cuspaceflight/skunk/README.md

skunk
=====

Source code, schematics and documentation for the Skunk Helium Gas Flow Meter Thing
