cuspaceflight/skunk/random docs/skunk pinout.odt

Between DB25 and board molex

board db25 function Colour DB25<=>board

1. 15 keysw orange (live side) brown
2. 13 pot red (to +5V) pink
3. 12 pot yellow (analog output) white
4. 10 piezo black, lcd black, keysw green, pot black (ground) purple
5. 11 piezo red (live side) orange
6. 5 lcd red (3.3V +V) blue
7. 6 lcd violet (Data @3.3V) yellow
8. 19 keypad green C3 brown
9. 18 keypad yellow R1 green
10. 17 keypad violet R4 pink
11. 21 keypad white C2 white
12. 22 keypad pink R2 orange
13. 23 keypad blue R3 blue
14. 25 keypad orange C1 yellow

Keypad colour coding: (between DB25 and keypad itself)

R1 | Yellow
R2 | Pink
R3 | Blue
R4 | Violet
C1 | Orange
C2 | White
C3 | Green

Arduino pin assignments

Pin | Label | Comments | Function | I/O/A | Schematic Label
VIN | Vin | 7-12V recommended | Unregulated power in | I | VIN
GND | GND | | Digital/analog ground | I/O | GND
+5V | +5V | Regulated 5V out | Used for flow-rate pot | O | +5V
PE0 | 0 | UART0 RX | Used for programming | I
PE1 | 1 | UART0 TX | Used for programming | O
PB0 | 53 | UART1 RX | Used for flowmeter comms | I | UART1_RX
PH6 | 9 | UART1 TX | Used for flowmeter comms | O | UART1_TX
PH5 | 3 | | Unused but reserved | -
PH4 | 7 | | Used for LCD comms | O | LCD_DATA
PF0 | A0 | ADC0 | Used for flowrate pot | A | FLOWPOT
PE3 | 5 | Digital pin 5 | Keyswitch input | I | KEYSW_IN
| 37 | Digital pin 37 | Keypad R1 | O | R1
| 35 | Digital pin 36 | Keypad R2 | O | R3
| 36 | Digital pin 35 | Keypad R3 | O | R2
| 34 | Digital pin 34 | Keypad R4 | O | R4
| 33 | Digital pin 33 | Keypad C1 | I | C1
| 32 | Digital pin 32 | Keypad C2 | I | C2
| 31 | Digital pin 31 | Keypad C3 | I | C3
PF1 | A1 | ADC1 | Battery voltage sense | A | BATT_IN
PC7 | 30 | Digital pin 30 | Speaker output | O | SPK

(Pins shown are power input, UART 0 and 1 and 2 used for programming and flowmeter and LCD respectively, and those used for peripherals)

DSUB9 between arduino case and flowmeter

Connection Wire colour DSUB9 pin Board pin

TX Green 1 5

GND Thick black 4 1

RX White 6 4

+V Red 7 3

0V Sense Thin black 8 2
