cuspaceflight/skunk/random docs/skunk random info.pdf

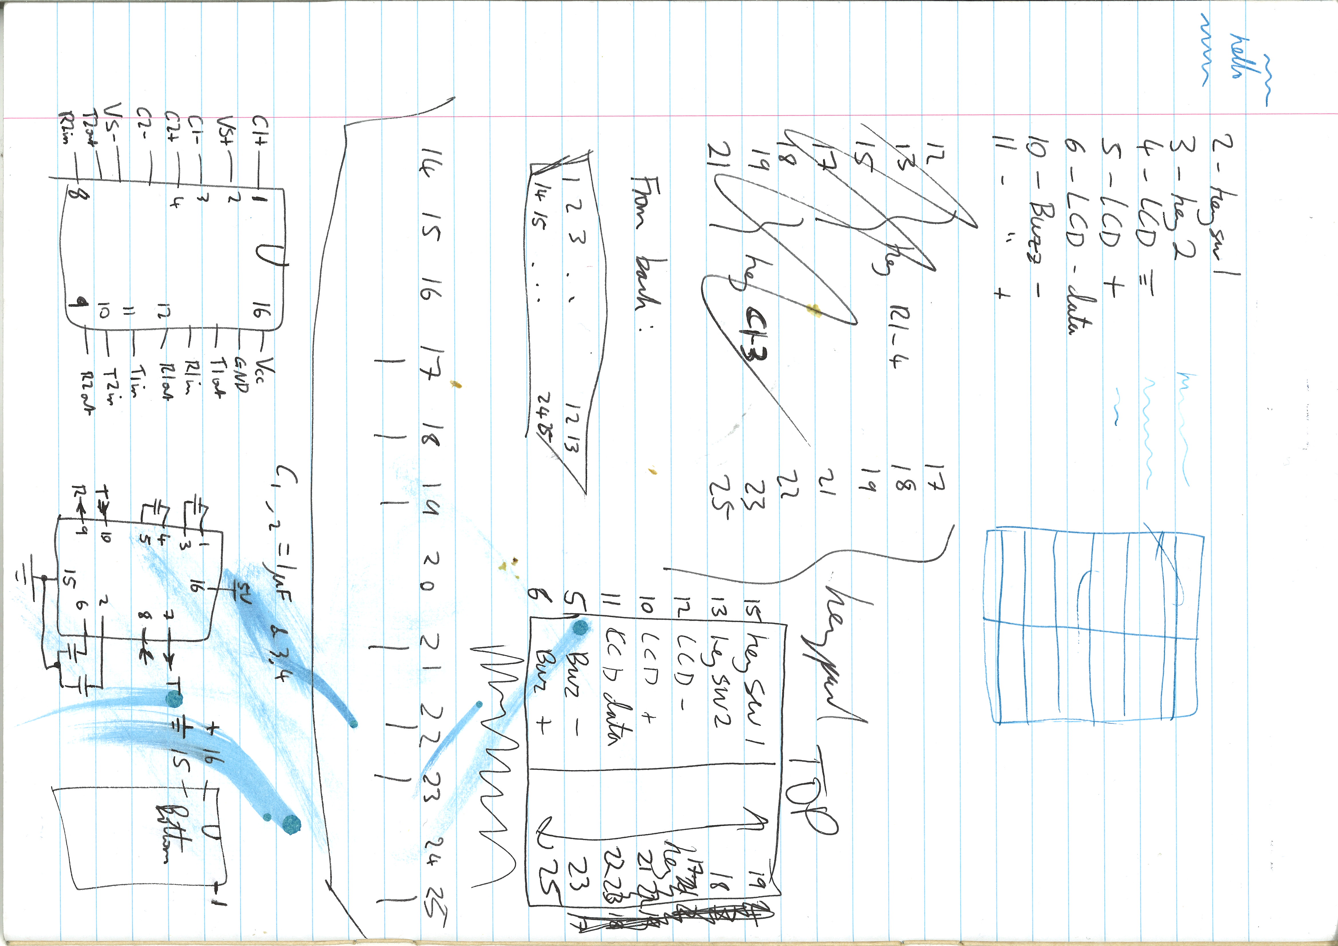
[picture p1: page 1]
