cuspaceflight/skunk/random docs/Skunk prototype parts.ods

Name | Quantity | Source | Part no |  | Link | Comment
Stripboard | 1 |  |  | 7.48 | http://onecall.farnell.com/kelan/147899/stripboard-single-sided/dp/147899
Flow control pot | 1 |  |  | 1.61 | http://onecall.farnell.com/te-connectivity-citec/23esa103mmf50nf/potentiometer-lin-10k/dp/350072 | 6.35mm shaft
Pot knob :) | 1 |  |  | 1.58 | http://onecall.farnell.com/bulgin/kx0607/knob-black/dp/1209726 | 6.35mm shaft
Keypad | 1 |  |  | 4.55 | http://onecall.farnell.com/multicomp/mcak304nbwb/keypad-3x4-array-plastic/dp/1182236 | Numerical + enter/cancel?
Beeper | 1 |  |  | 1.84 | http://onecall.farnell.com/pro-signal/abi-023-rc/piezo-buzzer-12vdc-leads/dp/1022400?Ntt=1022400 | BEEP!
MAX232 | 1 |  |  | 0.7 | http://onecall.farnell.com/texas-instruments/max232in/eia-232-driver-receiver-dual-16dip/dp/1648737
1uF caps for 232 | 5 |  |  | 0.25 | http://onecall.farnell.com/multicomp/np16v105m5x11/capacitor-n-p-1uf-16v/dp/1236655
Pulldowns for keypad | 50 |  |  | 0.4 | http://onecall.farnell.com/multicomp/mcre000049/resistor-carbon-film-125mw-10k/dp/1700251
Keyswitch | 1 |  |  | 2.7 | http://onecall.farnell.com/multicomp/ns106-1/keyswitch-spst-2pos-rdm-1keypull/dp/1735376
