cuspaceflight/skunk/schematics/skunk.sch

## KiCad design schematics/skunk.sch (2013-02-03, an earlier design)

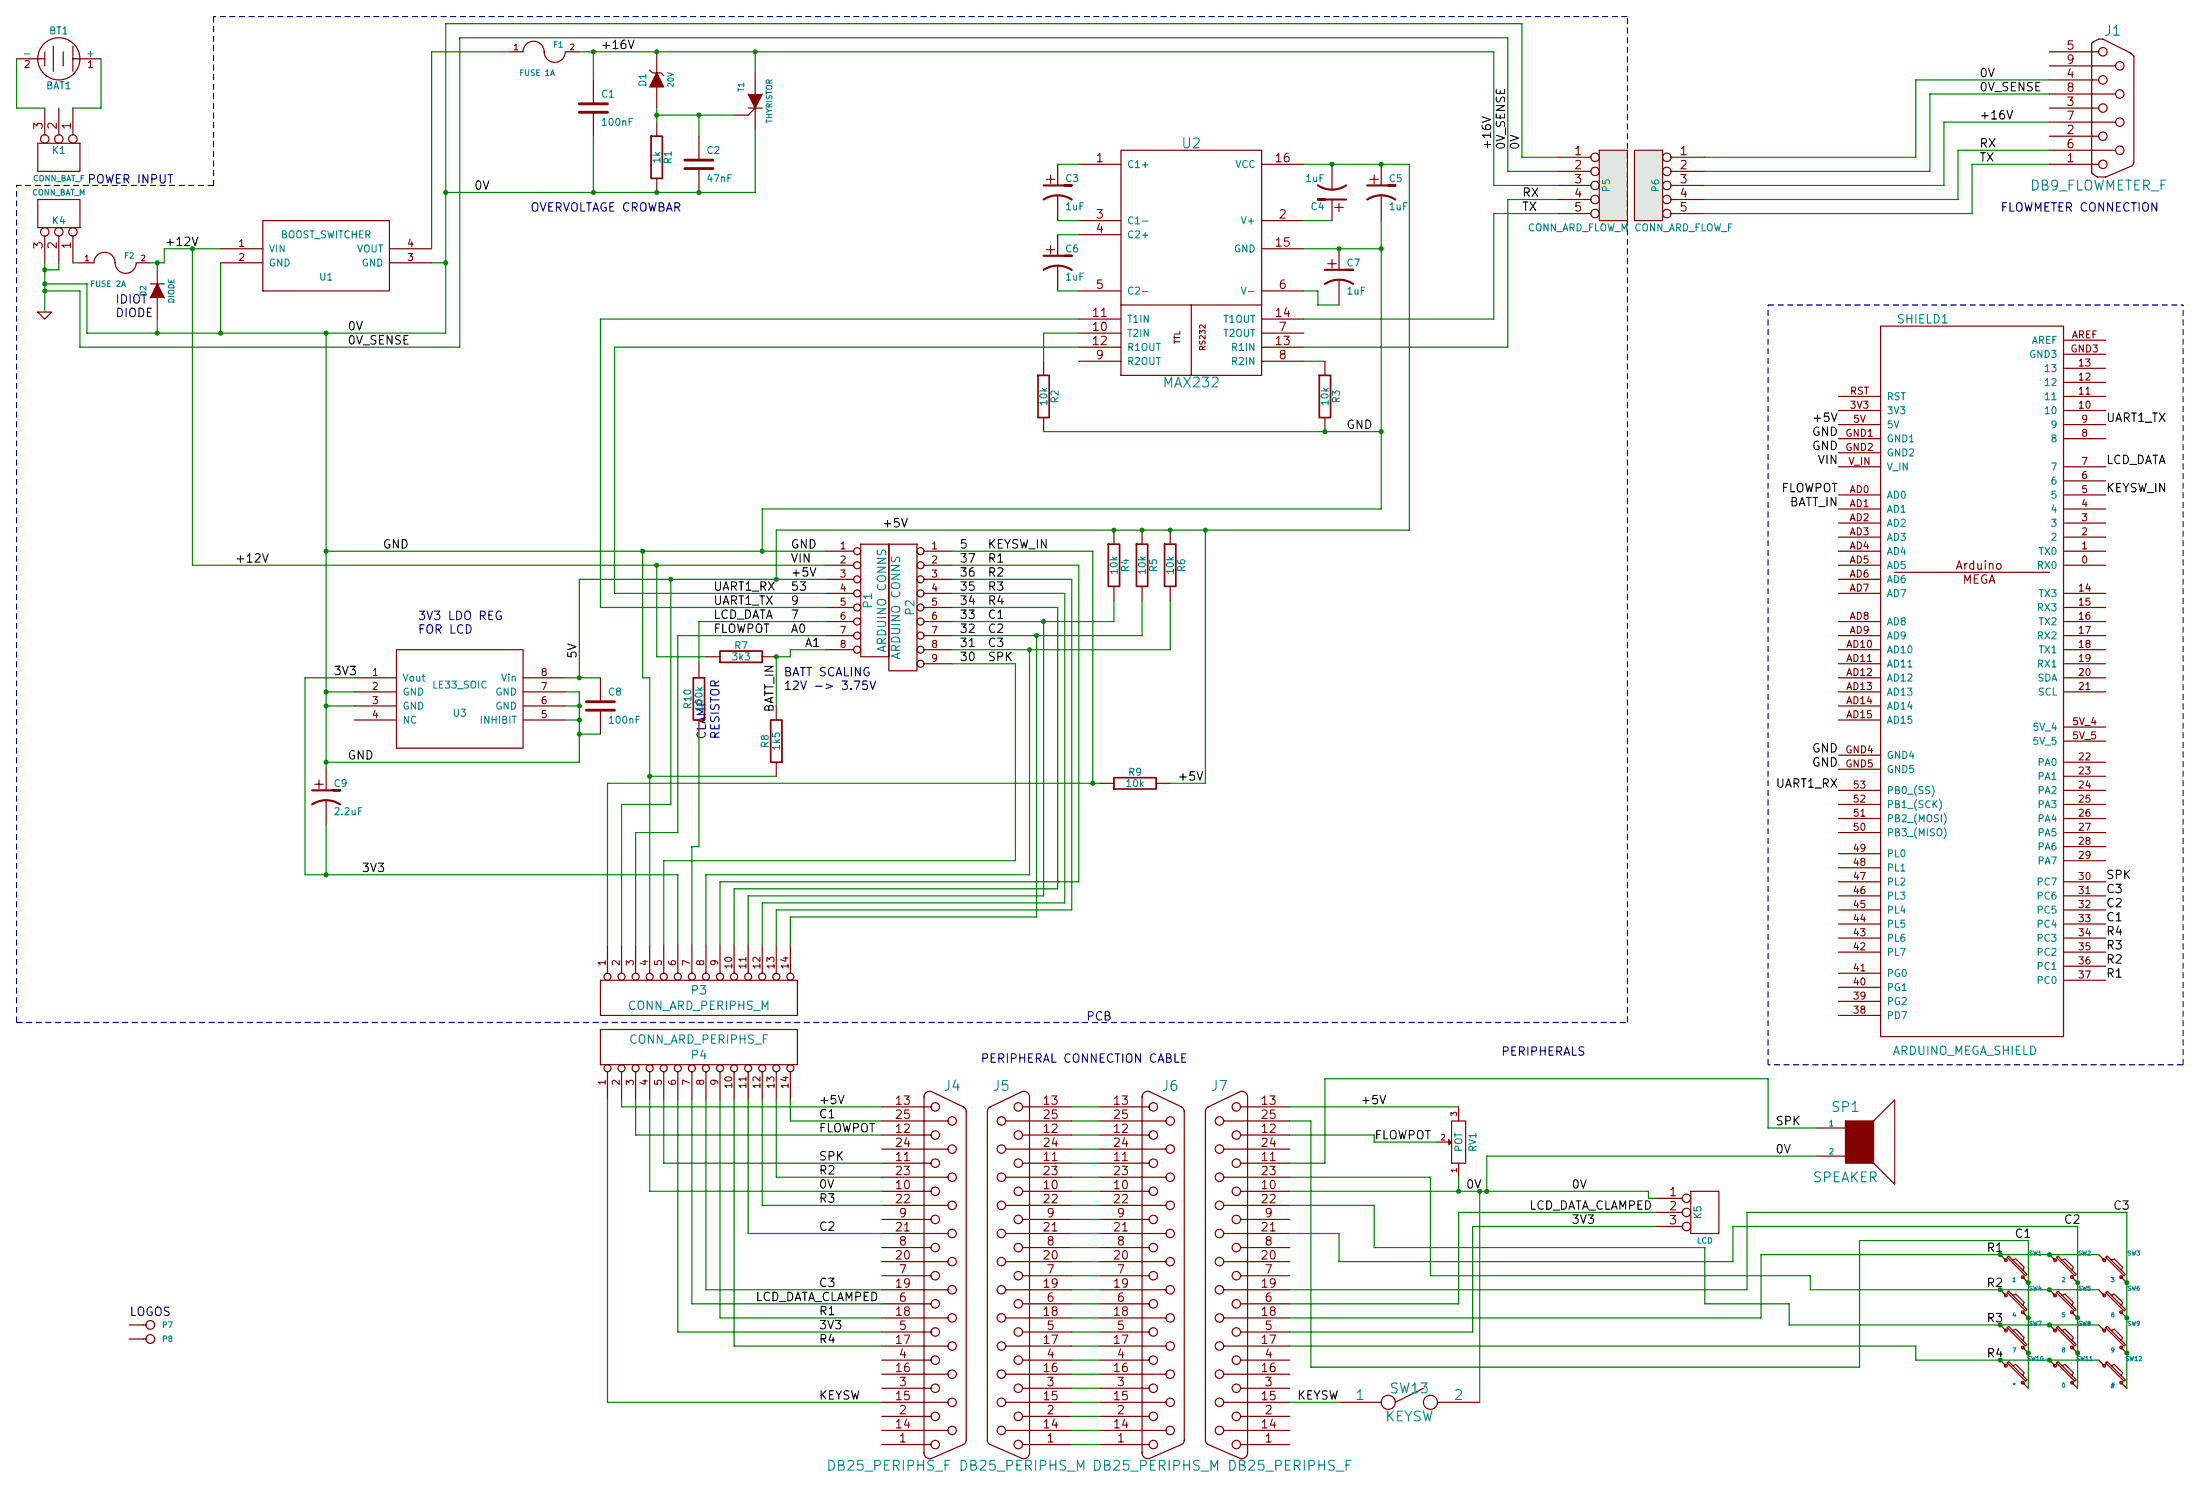
[picture p2: schematic skunk.sch]

Parts:
BT1: BAT1
C1, C8: 100nF; Farnell CA06644
C2: 47nF; Farnell CA06675
C3, C4, C5, C6, C7: 1uF; Farnell 1828853
C9: 2.2uF; Farnell 1828852
D1: 20V; Farnell 1612407
D2: DIODE; Farnell 1624992
F1: FUSE 1A; Farnell 1453528x2,1123079
F2: FUSE 2A; Farnell 1453528x2,1123175
J1: DB9_FLOWMETER_F
J4, J7: DB25_PERIPHS_F
J5, J6: DB25_PERIPHS_M
K1: CONN_BAT_F
K4: CONN_BAT_M; Farnell 1608727
K5: LCD
P1, P2: ARDUINO CONNS
P3: CONN_ARD_PERIPHS_M
P4: CONN_ARD_PERIPHS_F
P5: CONN_ARD_FLOW_M; Farnell 9731679
P6: CONN_ARD_FLOW_F; Farnell 1462874
P7, P8: CONN_1
R1: 1k; Farnell 1500663
R2, R3, R4, R5, R6, R9: 10k; Farnell 1653284
R7: 3k3; Farnell 1500706
R8: 1k5; Farnell 1653291
R10: 100k; Farnell 1653286
RV1: POT
SHIELD1: ARDUINO_MEGA_SHIELD; Farnell 1056428,1098454x2
SP1: SPEAKER
SW1: 1
SW2: 2
SW3: 3
SW4: 4
SW5: 5
SW6: 6
SW7: 7
SW8: 8
SW9: 9
SW10: *
SW11: 0
SW12: #
SW13: KEYSW
T1: THYRISTOR; Farnell 2101366
U1: BOOST_SWITCHER; MODULE
U2: MAX232; Farnell 1470443
U3: LE33_SOIC; MODULE; Farnell 1652371

Connections:
3V3: C9.2, J4.5, J7.5, K5.3, P3.6, P4.6, U3.1 (Vout)
5: P2.1, P3.1, R9.1, SHIELD1.5
7: P1.6, R10.2, SHIELD1.7
9: P1.5, SHIELD1.9, U2.11 (T1IN)
30: J4.11, J7.11, P2.9, P3.5, P4.5, SHIELD1.30 (PC7), SP1.1
31: J4.19, J7.19, P2.8, P3.8, P4.8, R6.2, SHIELD1.31 (PC6), SW3.2, SW6.2, SW9.2, SW12.2
32: J4.21, J7.21, P2.7, P3.14, P4.11, R5.2, SHIELD1.32 (PC5), SW2.2, SW5.2, SW8.2, SW11.2
33: J4.25, J7.25, P2.6, P3.11, P4.14, R4.2, SHIELD1.33 (PC4), SW1.2, SW4.2, SW7.2, SW10.2
34: J4.17, J7.17, P2.5, P3.10, P4.10, SHIELD1.34 (PC3), SW10.1, SW11.1, SW12.1
35: J4.22, J7.22, P2.4, P3.12, P4.12, SHIELD1.35 (PC2), SW7.1, SW8.1, SW9.1
36: J4.23, J7.23, P2.3, P3.13, P4.13, SHIELD1.36 (PC1), SW4.1, SW5.1, SW6.1
37: J4.18, J7.18, P2.2, P3.9, P4.9, SHIELD1.37 (PC0), SW1.1, SW2.1, SW3.1
53: P1.4, SHIELD1.53 (PB0_(SS)), U2.12 (R1OUT)
+5V: C4.2, C5.1, C8.1, J4.13, J7.13, P1.3, P3.2, P4.2, R4.1, R5.1, R6.1, R9.2, RV1.3, SHIELD1.5V, U2.16 (VCC), U3.8 (Vin)
+12V: D2.2 (K), F2.2, P1.2, R7.1, SHIELD1.V_IN, U1.1 (VIN)
+16V: C1.1, D1.2 (K), F1.2, J1.7, P5.3, P6.3, T1.A
A0: J4.12, J7.12, P1.7, P3.3, P4.3, RV1.2, SHIELD1.AD0
A1: P1.8, R7.2, R8.2, SHIELD1.AD1
GND: C1.2, C2.2, C5.2, C7.1, C8.2, C9.1, D2.1 (A), J1.4, J1.8, J4.10, J7.10, K4.2 (PM), K4.3, K5.1, P1.1, P3.4, P4.4, P5.1, P5.2, P6.1, P6.2, R1.2, R2.2, R3.2, R8.1, RV1.1, SHIELD1.GND1, SHIELD1.GND2, SHIELD1.GND4, SHIELD1.GND5, SP1.2, SW13.2, T1.K, U1.2 (GND), U1.3 (GND), U2.15 (GND), U3.2 (GND), U3.3 (GND), U3.5 (INHIBIT), U3.6 (GND), U3.7 (GND)
KEYSW: J4.15, J7.15, P4.1, SW13.1
LCD_DATA_CLAMPED: J4.6, J7.6, K5.2 (PM), P4.7
unnamed: BT1.1 (+), K1.1
unnamed: BT1.2 (-), K1.3
unnamed: C2.1, D1.1 (A), R1.1, T1.G
unnamed: C3.1, U2.1 (C1+)
unnamed: C3.2, U2.3 (C1-)
unnamed: C4.1, U2.2 (V+)
unnamed: C6.1, U2.4 (C2+)
unnamed: C6.2, U2.5 (C2-)
unnamed: C7.2, U2.6 (V-)
unnamed: F1.1, U1.4 (VOUT)
unnamed: F2.1, K4.1
unnamed: J5.1, J6.1
unnamed: J5.2, J6.2
unnamed: J5.3, J6.3
unnamed: J5.4, J6.4
unnamed: J5.5, J6.5
unnamed: J5.6, J6.6
unnamed: J5.7, J6.7
unnamed: J5.8, J6.8
unnamed: J5.9, J6.9
unnamed: J5.10, J6.10
unnamed: J5.11, J6.11
unnamed: J5.12, J6.12
unnamed: J5.13, J6.13
unnamed: J5.14, J6.14
unnamed: J5.15, J6.15
unnamed: J5.16, J6.16
unnamed: J5.17, J6.17
unnamed: J5.18, J6.18
unnamed: J5.19, J6.19
unnamed: J5.20, J6.20
unnamed: J5.21, J6.21
unnamed: J5.22, J6.22
unnamed: J5.23, J6.23
unnamed: J5.24, J6.24
unnamed: J5.25, J6.25
unnamed: P3.7, R10.1
unnamed: R2.1, U2.10 (T2IN)
unnamed: R3.1, U2.8 (R2IN)
RX: J1.6, P5.4, P6.4, U2.13 (R1IN)
TX: J1.1, P5.5, P6.5, U2.14 (T1OUT)

Notes on the sheet:
POWER INPUT
OVERVOLTAGE CROWBAR
IDIOT DIODE
FLOWMETER CONNECTION
PERIPHERAL CONNECTION CABLE
PERIPHERALS
CLAMP RESISTOR
BATT SCALING 12V -> 3.75V
3V3 LDO REG FOR LCD
PCB
LOGOS
