cuspaceflight/skunk/arduino firmware/Skunk-Firmware/SkunkPinDefs.h

#ifndef SKUNKPINDEFS_H
#define SKUNKPINDEFS_H

#define PIN_KEYSW  5

#define PIN_LCD  7

#define PIN_PIEZO  30

#define PIN_KNOB  A0

#define PIN_R1  37
#define PIN_R2  35
#define PIN_R3  36
#define PIN_R4  34
#define PIN_C1  32
#define PIN_C2  33
#define PIN_C3  31

#define FLOW_SERIAL Serial1

#endif
