cuspaceflight/skunk/(commit log)

2012-09-26 Initial commit of schematics
    New blank schematics + kicad project + schematics folder
    [skunk.sch]
2012-09-26 Imported flowmeter docs, some renaming
2012-09-26 Added battery supply to schematic & gitignore
    [skunk.sch]
2012-09-26 Finished flowmeter wiring harness
    [skunk.sch]
2012-09-26 Fixed flowmeter wiring harness, added ARD box
    [skunk.sch]
2012-09-26 Added peripheral DB25 connectors
    [skunk.sch]
2012-09-26 Initial commit of prototype parts list
    [Skunk prototype parts.ods]
2012-09-27 Added peripherals & DB25 to schematic
    [skunk.sch]
2012-09-27 Budged peripherals around a bit
    [skunk.sch]
2012-09-27 Added regulator to schematic
    [skunk.sch]
2012-10-05 Enlarged schem paper size, replace 317 and 2nd batt with boost switcher
    [skunk.sch]
2012-10-05 Added DB25 cable to schem
    [skunk.sch]
2012-10-05 Added crowbar circuit and idiot diode to schem
    [skunk.sch]
2012-10-05 Added schem sheet annotation and labels
    [skunk.sch]
2012-10-05 added arduino pinout spec
    [skunk.sch]
2012-10-05 Added pin labels to ard pinout
2012-10-05 Added arduino pins with numbers and functions
    [skunk.sch]
2012-10-05 Corrected arduino pin function labels
    [skunk.sch]
2012-10-05 Added keypad pullups and extra labelling
    [skunk.sch]
2012-10-05 Added SPK pin to arduino IO
    [skunk.sch]
2012-10-05 Updated TODO and finished most peripheral interface electronics
    [skunk.sch]
2012-10-15 Added LCD clamp diode current limit resistor
    [skunk.sch]
2012-10-15 Added battery sense input scaling
    [skunk.sch]
2012-10-15 Added connector gender labels
    [skunk.sch]
2012-10-17 Clarified representation of boost switcher module
    [skunk.sch]
2012-10-17 Added max232 on flowmeter rs232 circuit
    [skunk.sch]
2012-10-17 Added proper LE33 part for LCD 3V3 reg
    [skunk.sch]
2012-10-17 Made LE33 part less fugly
    [skunk.sch]
2012-11-02 Skunk Program - Simulator Runs Fine
    Program for the Skunk flowmeter controller, currently runs to take input
    from and send output to a terminal (or rather command prompt). Some
    improvements can be made. Once the some functions are redefined to run
    on the arduino (which will involve some lab time), then this program
    will be able to control the flowmeter (hopefully!). (Also, some
    improvements do need to be made still, e.g. actual settings to change.)
2012-11-04 Significant updates - see extended description
    + Followed some suggestions concerning defining arduino or pc at start
    of program, to allow certain parts to compile depending on situation -
    Many thanks to Adam and David.
    + Added in serLCD libraries to same folder and interatctions in display
    function.
    + Shortened all strings to only output max 16 chars, and added double
    checking on display, and at other places
    + Some restructuring of various functions for display improvements (no
    redraws if not needed etc)
    + Backlight setting added
    + Arduino updateGlobalTimer now deals with the overflow of millis() with
    a minor pause, this could take 50 days to occur, and its unlikely that
    its gonna be left o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
    [serLCD.cpp, serLCD.h, skunk.cpp]
2012-11-11 Cleanup of code
    Variable renaming, minor shuffling around, and removal of the timer
    overflow handling code.
2012-11-16 Started adding part numbers for components, added BOM, netlist and footprint-files
    [skunk.sch]
2012-11-17 Did a bunch more part numbers and footprints, changed LE33 to SOIC
    [skunk.sch]
2012-11-17 Renamed TO225 footprint lib
2012-11-17 Ok, there was confusion, latest kicad daily is broken. Should all work now in the stable in ubuntu 12.10, not sure about later
2012-11-17 More footprint work
    [skunk.sch]
2012-11-17 Added boost switcher component
2012-11-17 Changed boost switcher on schematic to component, removed unused arduino power connector, redid footprint stuff
    [skunk.sch]
2012-11-18 Added DIL-14 footprint for periph board conns
    [skunk.sch]
2012-11-18 Imported arduino shield components/module footprints
    [skunk.sch]
2012-11-18 Added schem labels to pinout, connected up shield pins on schem
    [skunk.sch]
2012-11-18 Added arduino mega to netlist, generated initial board
    [skunk.brd, skunk.sch]
2012-11-18 Added boost switcher footprint and updated netlist,board
    [skunk.brd, skunk.sch]
2012-11-18 Changed flowmeter connector on board to SIL5 inc power
    [skunk.brd, skunk.sch]
2012-11-18 Did some layout
    [skunk.brd, skunk.sch]
2012-11-18 Corrected error with LCD_DATA clamp resistor being in silly place
    [skunk.brd, skunk.sch]
2012-11-18 Finished routing first rev. of board
    [skunk.brd, skunk.sch]
2012-11-19 Started 2nd rev of skunk layout
    [skunk.brd, skunk.sch, skunk_old.brd]
2012-11-19 Finished layout and routing skunk PCB r2
    [skunk.brd, skunk.sch]
2012-11-19 Optimised ground planes on board
    [skunk.brd, skunk.sch]
2012-11-19 Enlarged board to sensible size and improved ground planes some more
    [skunk.brd]
2012-11-19 Prettied up the front silk layer
    [skunk.brd]
2012-11-19 Improved fuse clearance
    [skunk.brd]
2012-11-21 Added adam's PCB suggestions to TODO
2012-11-21 Removed rear ground plane splits and added stitching
    [skunk.brd]
2012-11-21 Added farnell part for forgotten resistor, generated CSV BOM
    [skunk.csv, skunk.sch]
2012-11-21 Added logos to board. Finally
    [skunk.brd, skunk.sch]
2012-11-21 Removed unneeded silk junk from shield footprint
    [skunk.brd]
2012-11-22 Added gerber files
    [skunk-B_Mask.gbs, skunk-B_SilkS.gbo, skunk-Back.gbl, skunk-F_Mask.gts, skunk-F_SilkS.gto, skunk-Front.gtl, skunk.drl]
2012-11-22 Prettied up silk a bit more
    [skunk.brd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]
2012-11-22 Fixed ground plane stitching, changed barrel jack to round holed part
    [skunk.brd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]
2012-11-22 Enlarged MAX232 pads
    [skunk.brd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]
2012-11-22 Added pinouts to back of board
    [skunk.brd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]
2012-11-23 Decreased via drill size
    [skunk.brd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]
2012-11-23 Separated TX and RX lines, stitched 5V line
    [skunk.brd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]
2012-11-23 Increased drill sizes on shield pins
    [skunk.brd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]
2012-11-23 Added part numbers to some connectors, regenerated BOM
    [skunk.csv, skunk.sch]
2012-11-23 Enlarged hole sizes on periph and flowmeter headers
    [skunk.brd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]
2013-02-03 Corrected schematic and pin assignments
    [skunk.sch]
2013-02-04 Added board-DB25 wire colours to pinout doc
2013-02-06 Added DSUB9 through-cable pinout/colours
2013-02-06 Moved arduino testfiles into correct folders
2013-02-06 Fixed some pin assignments, keypad ones were wrong
2013-02-06 Added flowknob test program
2013-02-08 Added empty init flowmeter test program
2013-02-14 Worked on flowmeter comms software
2013-02-21 Fixed signed/unsigned bug in knobcontrol
    [knobcontrol.ino]
2013-02-21 Fixed display bug in knobcontrol
    [knobcontrol.ino]
2015-11-05 Added new Arduino project
2015-11-05 Added new drivers
2015-11-06 Added rudimentary class for communicating with the Flowmeter. Will likely not compile.
2015-11-07 Moved pin definitions to own file
2015-11-07 Added stubs for UI and Flowmeter Driver
2015-11-10 Updated files so it (mostly) validates in Arduino IDE.
2015-11-10 More stuff to the flowmeter driver stuff.
2015-11-10 Moved flowmeter control to FlowmeterDriver file. Updated Firmware file to initialise flowmeter properly.
2015-11-10 Some error left, updated user interface file
    [UserInterface.cpp, UserInterface.h]
2015-11-10 It compiles: TODO: Gradually reintroduce one function at a time fixing the errors
    [Skunk-Firmware.ino, UserInterface.cpp, UserInterface.h]
2015-11-10 Added start of flowmeter simulator
2015-11-15 Testable prototype: finished UI, fixed flowmeter driver, misc fixes
    [FlowmeterDriver.cpp, FlowmeterDriver.h, KnobDriver.cpp, PiezoDriver.cpp, Skunk-Firmware.ino, SkunkPinDefs.h, UserInterface.cpp]
2015-11-16 Fixes integer wrap around bug
    [UserInterface.cpp]
2015-11-16 Added a reset confirm menu option.
    [FlowmeterDriver.cpp, FlowmeterDriver.h, UserInterface.cpp, UserInterface.h]
2015-11-16 Misc bugfixes and tidying up
    [FlowmeterDriver.cpp, Skunk-Firmware.ino, UserInterface.cpp]
2017-03-13 started r3!
    [skunk-r3.kicad_pcb, skunk-r3.sch]
